kamtar/dykodac2/README.md

# DykoDAC2
Project: https://workspace.circuitmaker.com/Projects/Details/TomPoliensk/DykoDAC2
<br>
<br>
premake5 project
<br>schematics: https://github.com/kamtar/dykodac2/blob/master/hw-circuit-maker/Released/DykoDAC2.PDF
