kamtar/dykodac2/hw-circuit-maker/Released/DykoDAC2.PDF

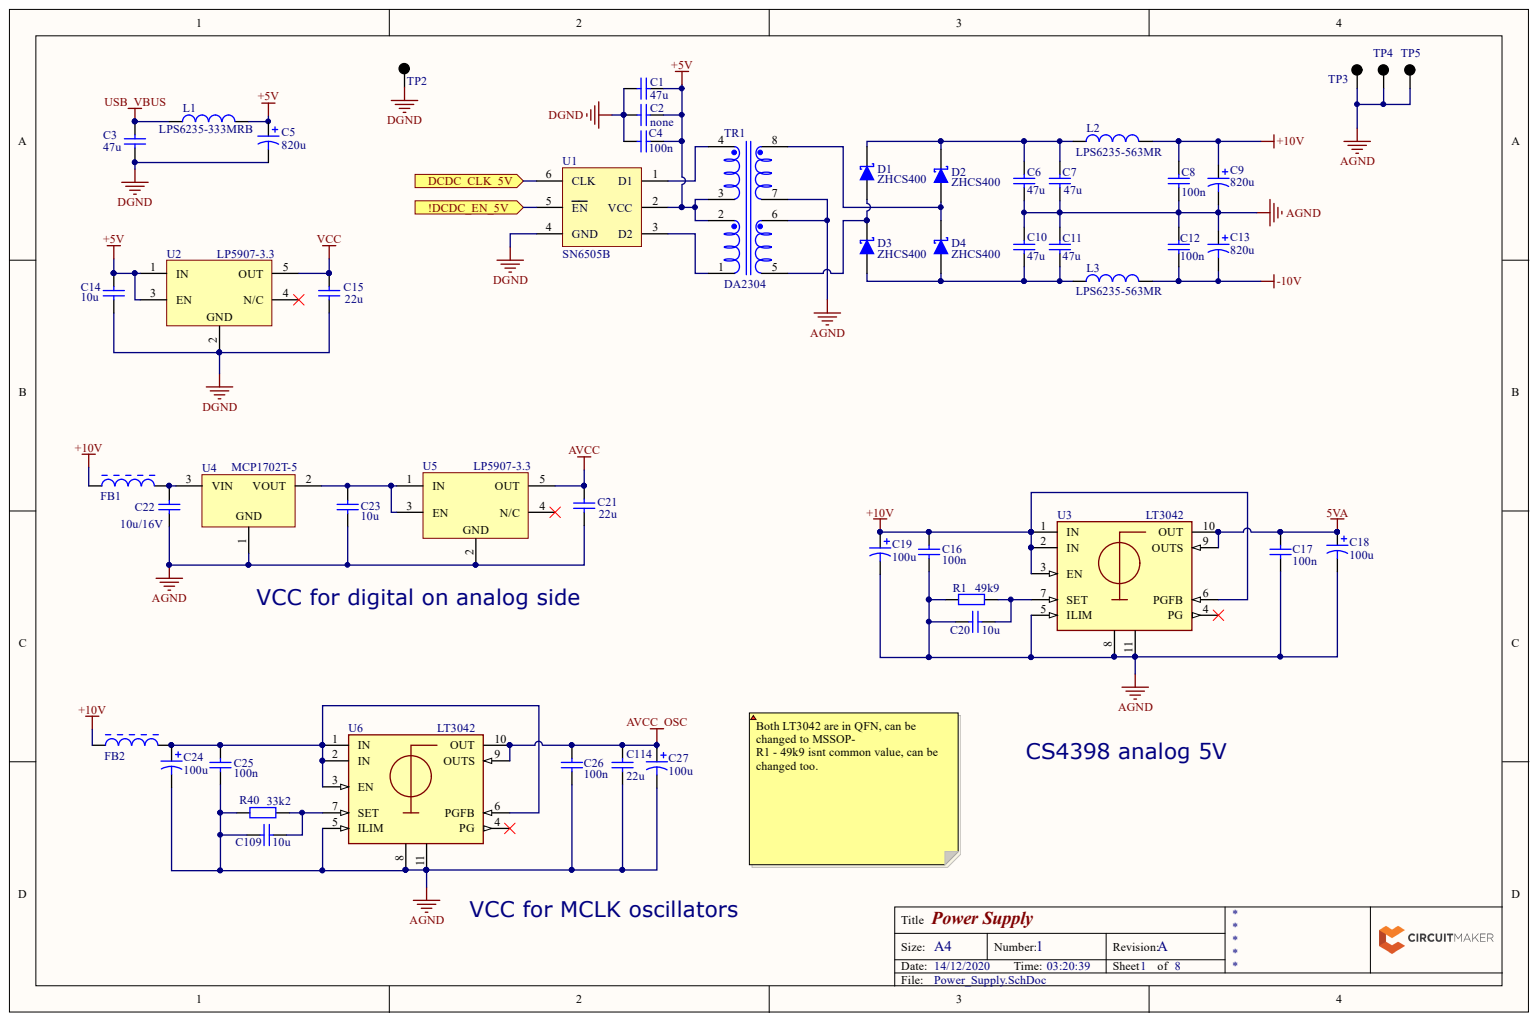
[picture p1: page 1]

VCC for digital on analog side

Both LT3042 are in QFN, can be
changed to MSSOP-
R1 - 49k9 isnt common value, can be
changed too.

PGFB PG | 4 ILIM 5 6 SET 7

VCC for MCLK oscillators

Power Supply Title | * *

Size: A4 | Number: 1 | Revision: A
Date: 14/12/2020 Time: 03:20:39 | | Sheet of

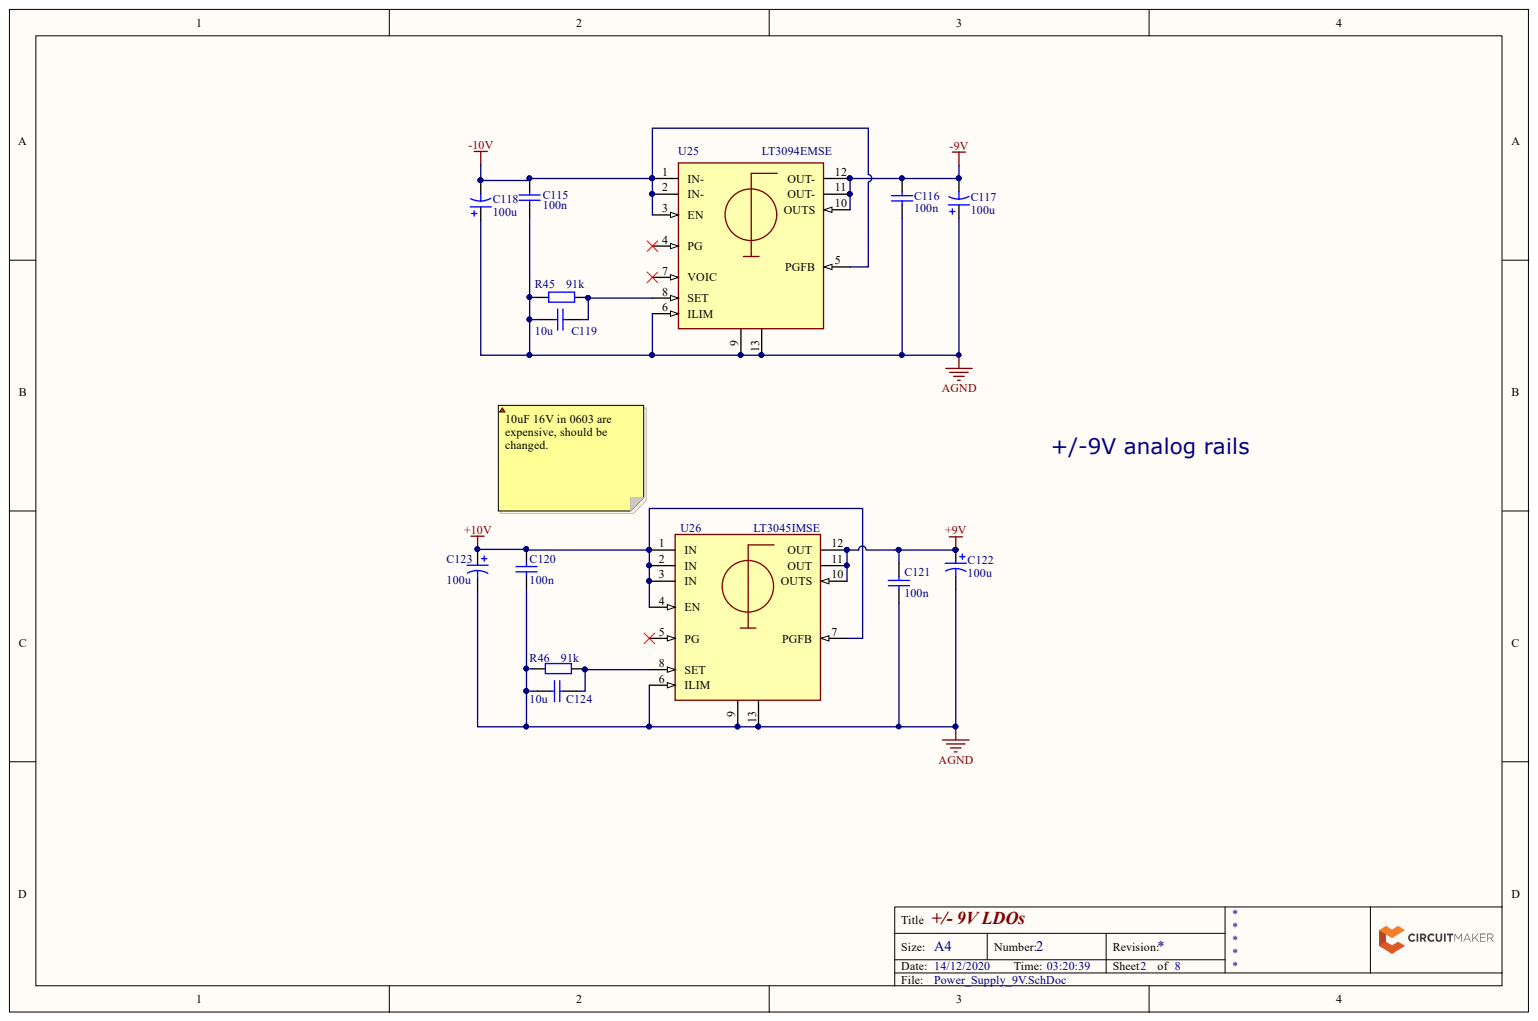
[picture p2: page 2]

C115 100n | IN- 2 | OUTS

EN 3 | 10 OUT-11

+/- 9V LDOs Title | * *

Size: A4 | Number: 2 | Revision: *

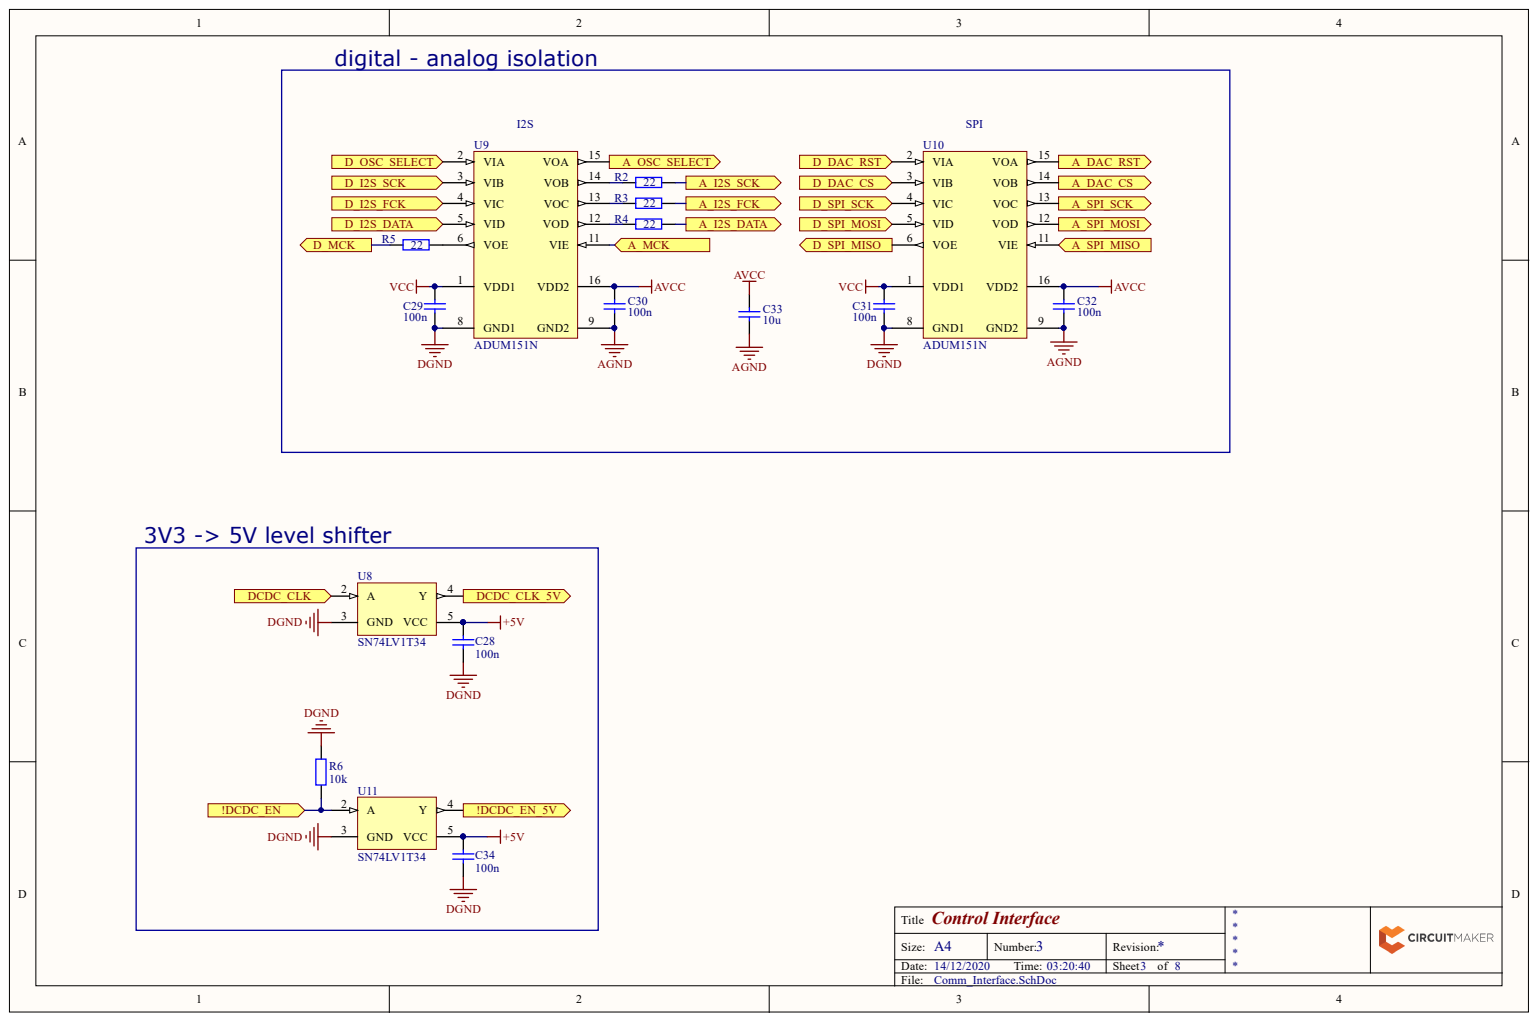
[picture p3: page 3]

Control Interface Title | * *

Size: A4 | Number: 3 | Revision: *

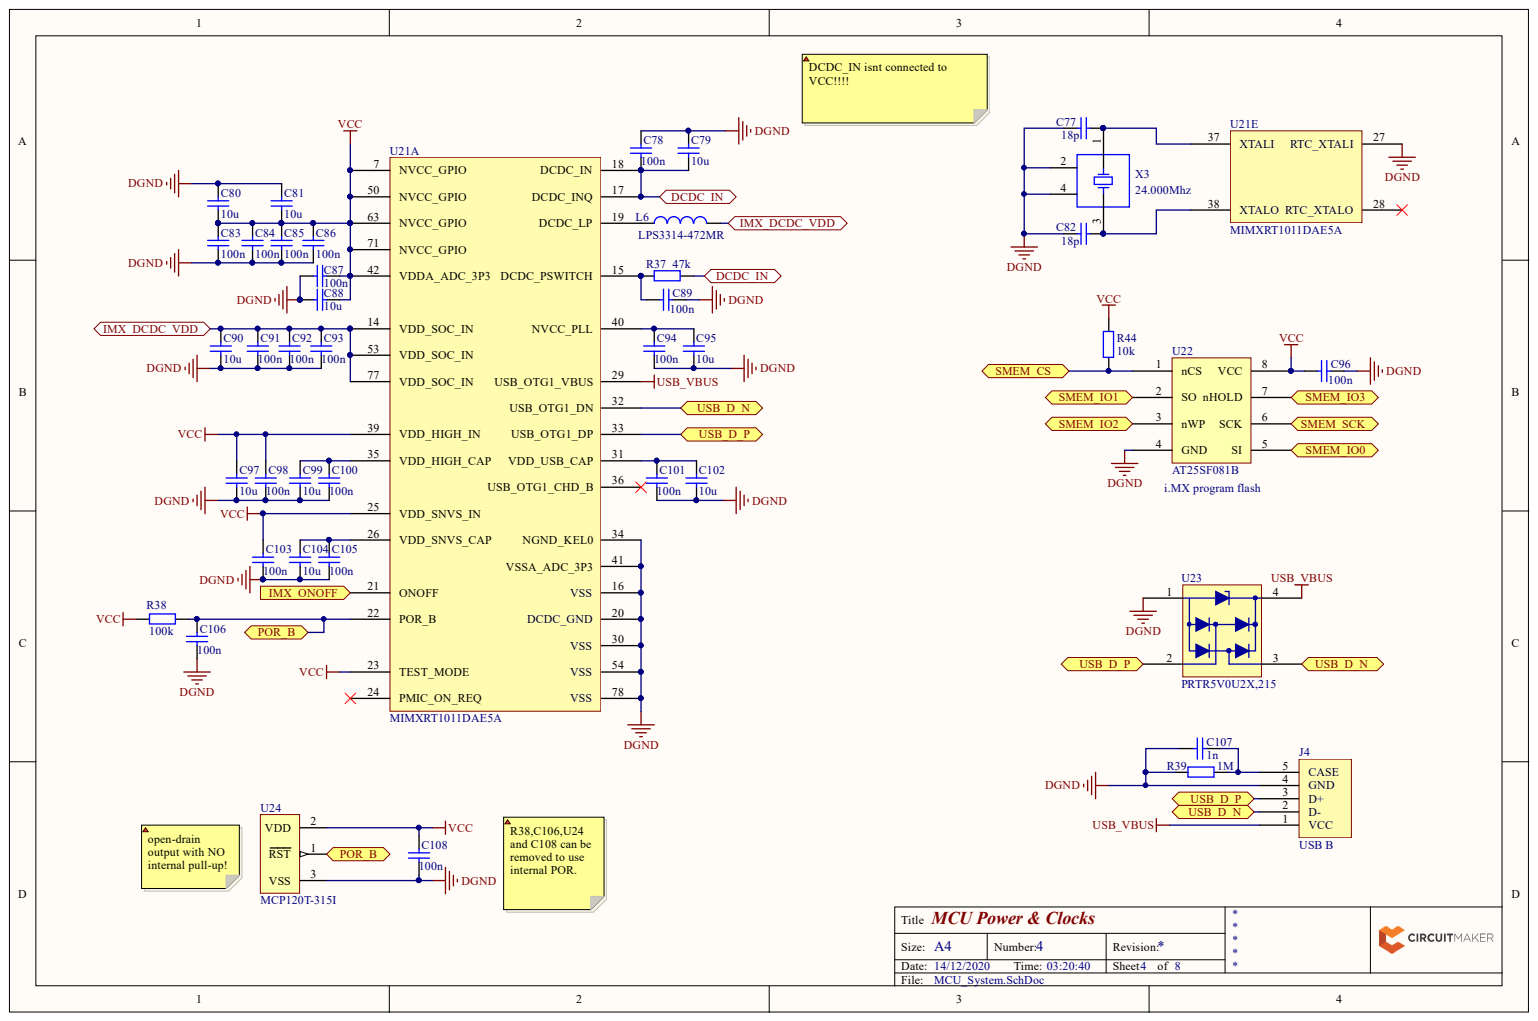
[picture p4: page 4]

XTALO 38

NVCC_GPIO 63 | L6

NVCC_GPIO 71

100n C88 | | | VDD_SOC_IN 14

ONOFF 21

TEST_MODE 23 | DGND

MCU Power & Clocks Title | * *

Size: A4 | Number: 4 | Revision: *

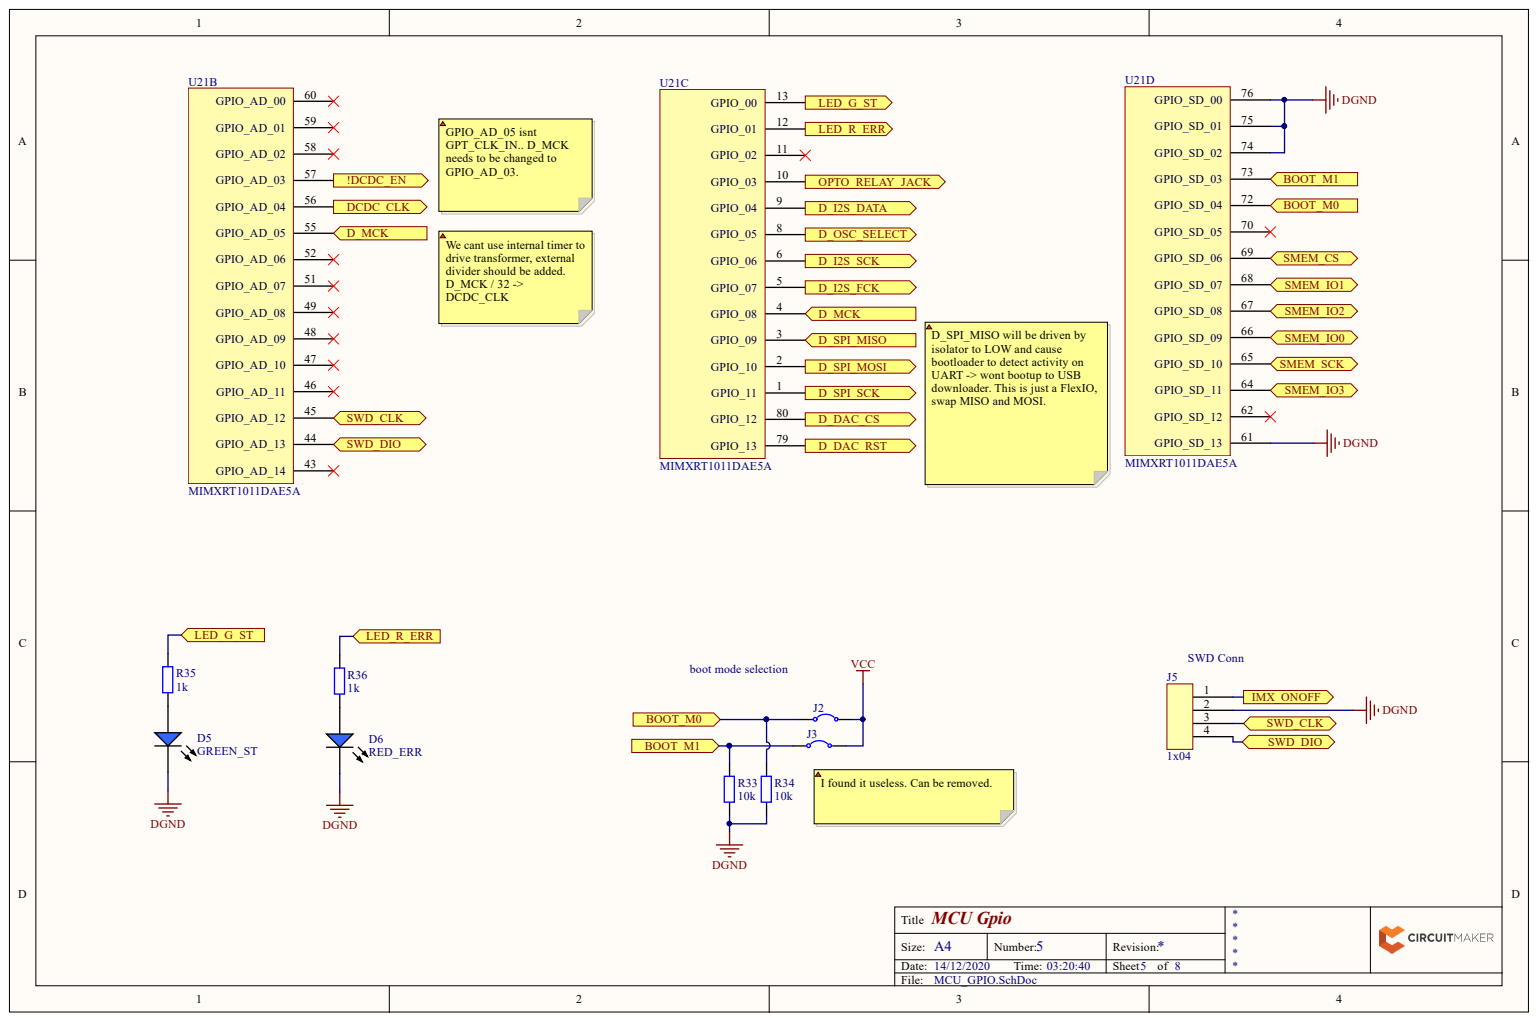
[picture p5: page 5]

We cant use internal timer to
drive transformer, external
divider should be added.
D_MCK / 32 ->
DCDC_CLK

D_SPI_MISO will be driven by
isolator to LOW and cause
bootloader to detect activity on
UART -> wont bootup to USB
downloader. This is just a FlexIO,
swap MISO and MOSI.

I found it useless. Can be removed.

MCU Gpio Title | * *

Size: A4 | Number: 5 | Revision: *

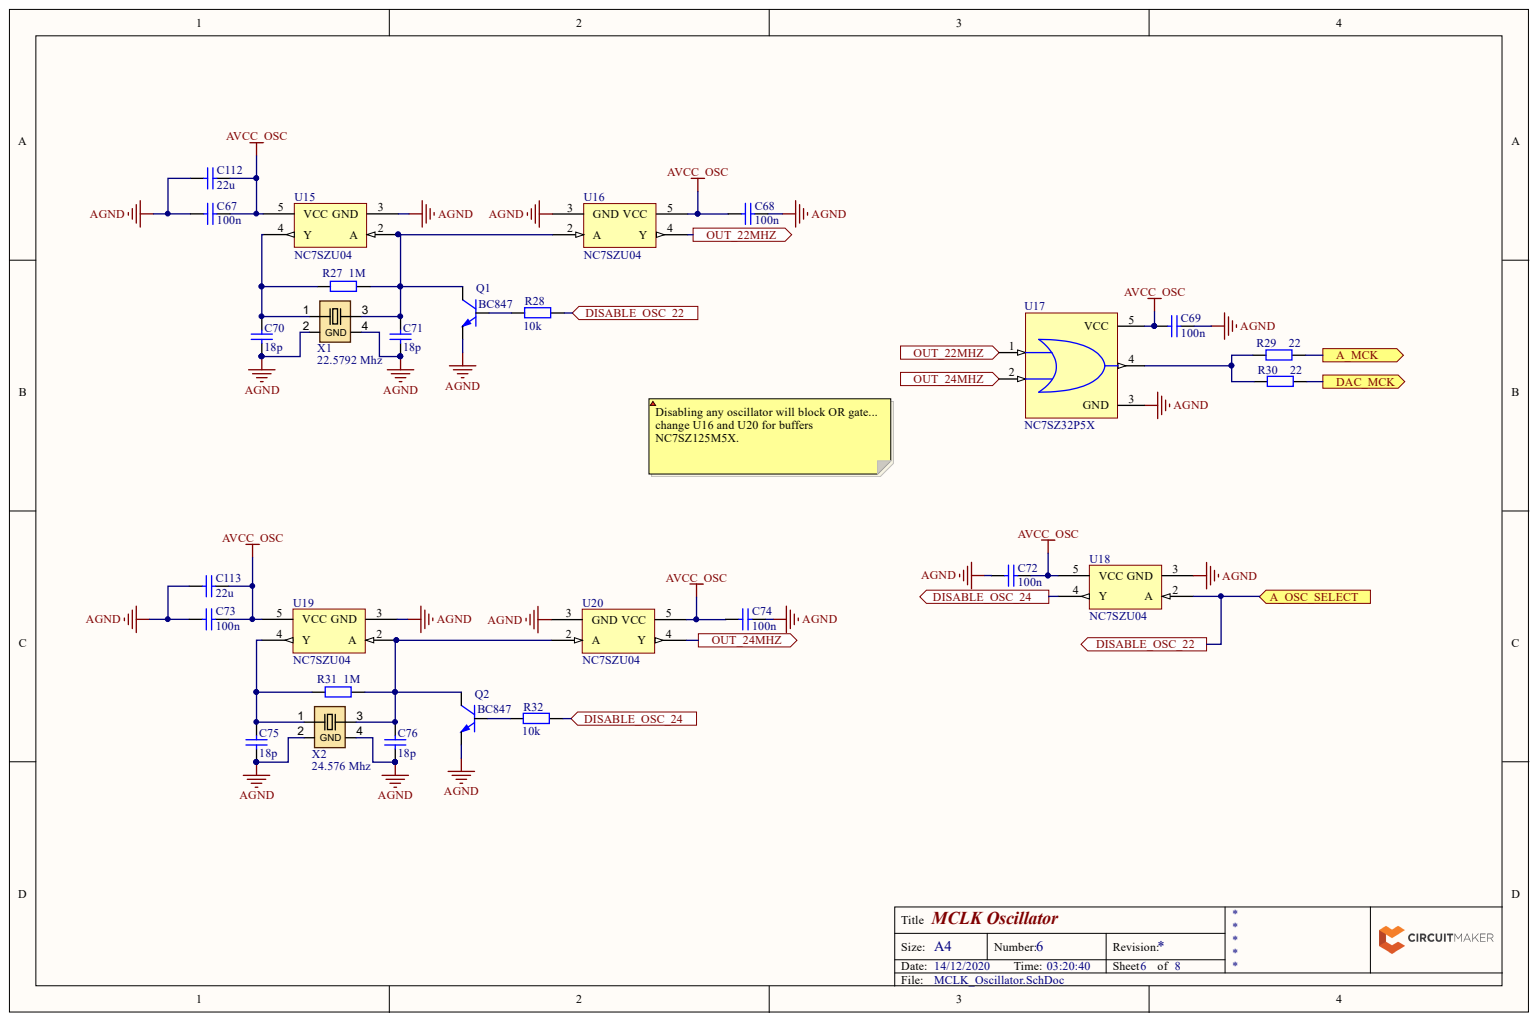
[picture p6: page 6]

Disabling any oscillator will block OR gate...
change U16 and U20 for buffers

MCLK Oscillator Title | * *

Size: A4 | Number: 6 | Revision: *

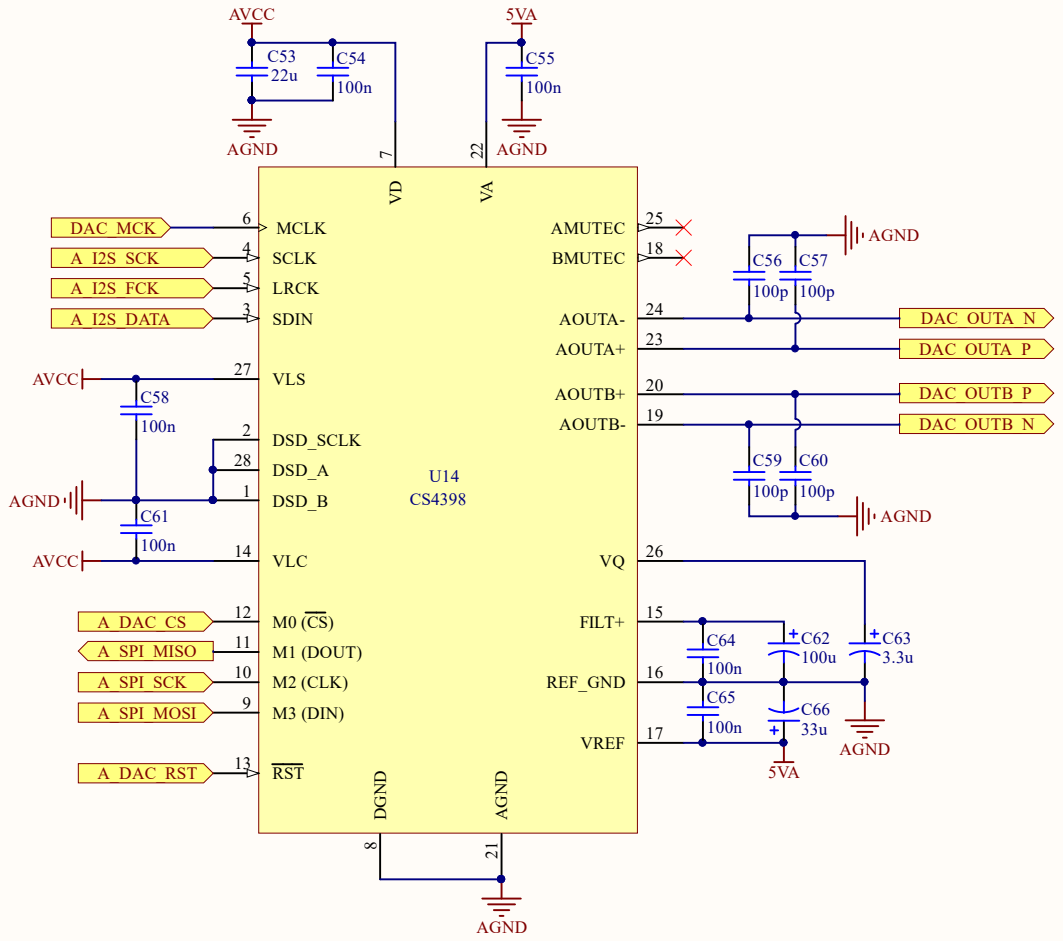
[picture p7: page 7]

CS4398 DAC Title | * *

Size: A4 | Number: 7 | Revision: *

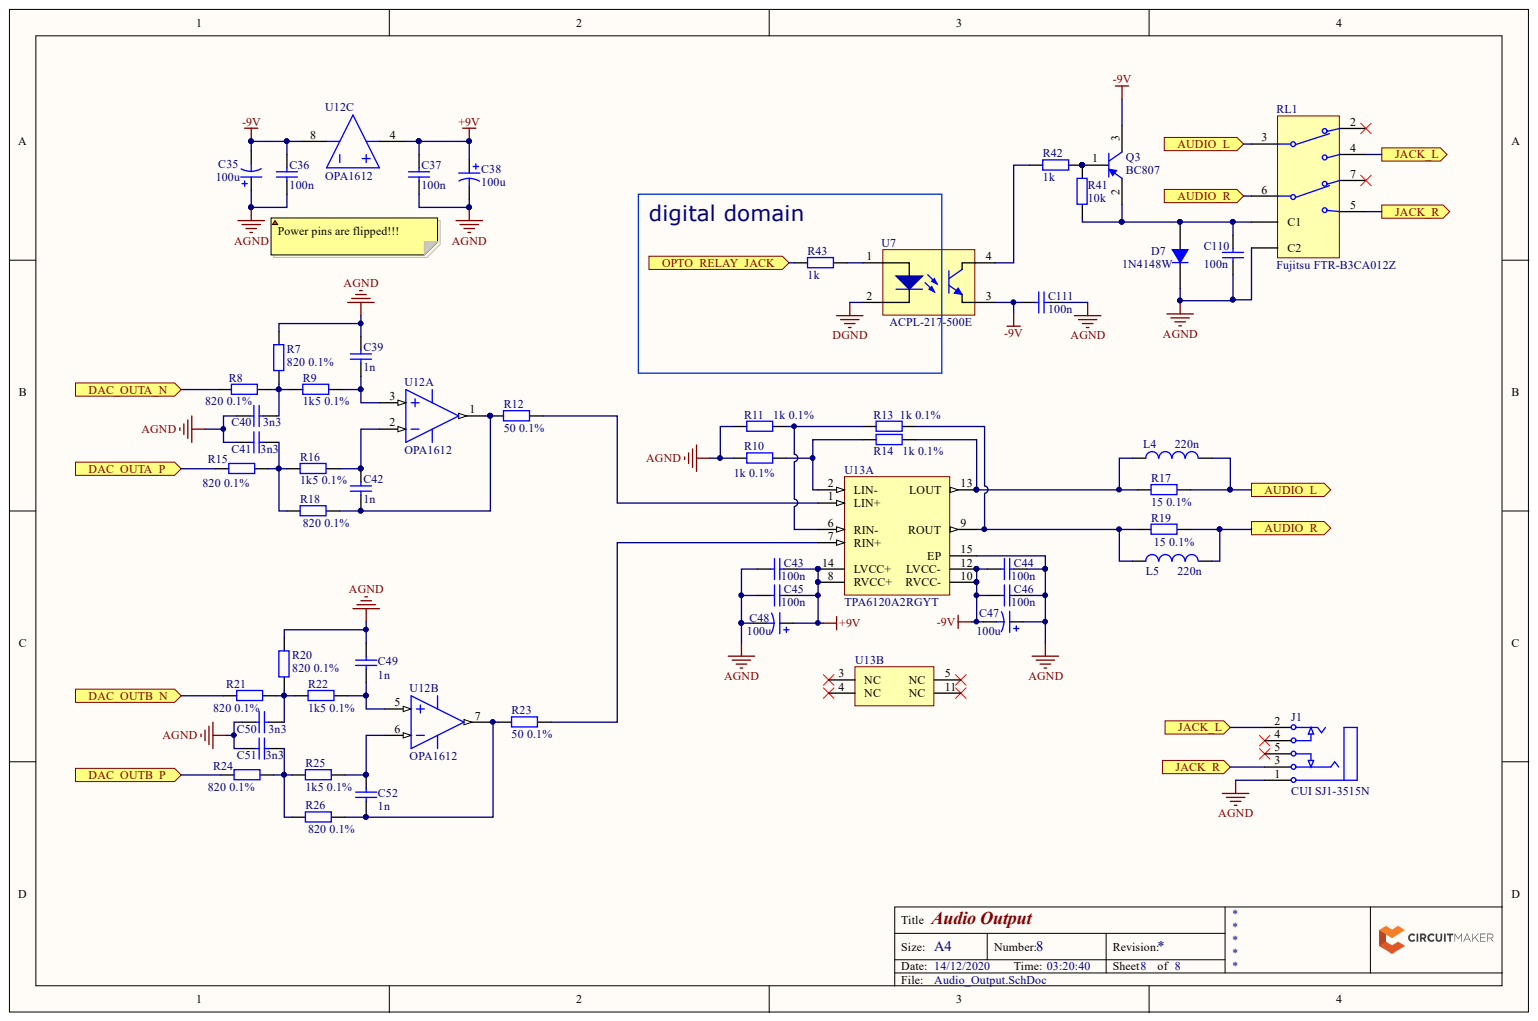
[picture p8: page 8]

digital domain Power pins are flipped!!!

RIN- 6

LVCC+ 14

Audio Output Title | * *

Size: A4 | Number: 8 | Revision: *
