kamtar/dykodac2/(list of files, drawings)

Other design files:
hw-circuit-maker/Design/Audio_Output.SchDoc
hw-circuit-maker/Design/Comm_Interface.SchDoc
hw-circuit-maker/Design/CS4398_DAC.SchDoc
hw-circuit-maker/Design/DykoDAC2.PrjPcb
hw-circuit-maker/Design/MCLK_Oscillator.SchDoc
hw-circuit-maker/Design/MCU_GPIO.SchDoc
hw-circuit-maker/Design/MCU_System.SchDoc
hw-circuit-maker/Design/Power_Supply.SchDoc
hw-circuit-maker/Design/Power_Supply_9V.SchDoc
