kamtar/dykodac2/fw/platform/nxp/main.cpp

#include "app/app_controller.hpp"
#include "audio/audio_engine.hpp"
#include "audio/feedback_controller.hpp"
#include "audio/sample_rate.hpp"
#include "audio/stream_buffer.hpp"
#include "board/clock_manager.hpp"
#include "board/monotonic_timer.hpp"
#include "board/output_relay.hpp"
#include "board/target_board.hpp"
#include "config/board_config.hpp"
#include "devices/dac.hpp"
#include "platform/nxp/flexio_dac_transport.hpp"
#include "platform/nxp/mpu_config.hpp"
#include "platform/nxp/rom_bootloader.hpp"
#include "platform/nxp/boot_control.hpp"
#include "usb/usb_device.hpp"

#include <new>

extern "C" {
#include "clock_config.h"
}

namespace {
enum class StartStep : std::uint8_t { None, RelayRelease, ClockSettle, DmaProgress, Prefill, Stable, DacSettle, Playing };
enum class StopReason : std::uint8_t {
    None, HostStop, Detached, Suspended, HostMuted, UnsupportedRate, UsbInit,
    DacConfigure, EngineStart, DmaNoProgress, Underrun, DmaError, DacUnmute,
    FinalInvariant, VolumeControl
};

struct Runtime {
    board::OutputRelay relay;
    board::ClockManager clocks;
    platform::nxp::FlexioDacTransport transport;
    devices::Cs4398 dac{transport};
    audio::StreamBuffer stream;
    audio::FeedbackController feedback;
    audio::AudioEngine engine;
    usb::UsbDevice usb;
    app::AppController app;
    const audio::FormatConfig* active{nullptr};
    const audio::FormatConfig* desired{nullptr};
    StartStep step{StartStep::None};
    std::uint32_t deadline{0U};
    std::uint32_t dma_baseline{0U};
    std::uint32_t underrun_baseline{0U};
    bool usb_ready{false};
    bool mounted{false};
    bool suspended{false};
    bool stream_requested{false};
    bool resume_pending{false};
    bool bootloader_armed{false};
    std::uint32_t bootloader_deadline{0U};
    bool updater_armed{false};
    std::uint32_t updater_deadline{0U};
    StartStep last_stop_step{StartStep::None};
    StopReason stop_reason{StopReason::None};
};

bool reached(std::uint32_t now, std::uint32_t deadline) {
    return static_cast<std::int32_t>(now - deadline) >= 0;
}

void safe_stop(Runtime& r, bool fault, StopReason reason = StopReason::None) {
    // Preserve the first fault stage/reason. Windows commonly sends one or
    // more alt-0 Stop requests after a failed start; those are consequences,
    // not the root cause and must not overwrite the evidence.
    if (reason != StopReason::None && (fault || r.app.state() != app::State::FaultMuted)) {
        r.last_stop_step = r.step;
        r.stop_reason = reason;
    }
    r.relay.disconnect();
    if (r.dac.ready_muted()) r.dac.set_mute(true);
    r.engine.stop();
    r.stream.clear();
    if (r.active) r.feedback.reset(*r.active, audio::StreamBuffer::capacity_bytes / 2U);
    r.usb.reset_stream();
    r.clocks.invalidate();
    r.step = StartStep::None;
    r.resume_pending = false;
    r.usb.set_clock_valid(false);
    r.app.dispatch(fault ? app::Event::Fault : app::Event::StopRequested);
    if (!fault) r.app.dispatch(app::Event::Stopped);
}

void enter_connected_idle(Runtime& r) {
    // A normal host alt-0 transition is only a pause while USB remains
    // mounted. Keep the already-settled analog path connected and feed the
    // DAC digital zero so relay switching cannot expose channel DC offset.
    r.engine.detach_stream();
    r.stream.clear();
    r.usb.reset_stream();
    r.usb.set_clock_valid(true);
    r.underrun_baseline = r.engine.underruns();
    r.resume_pending = false;
    r.stop_reason = StopReason::HostStop;
}

void begin_start(Runtime& r, std::uint32_t now) {
    r.relay.disconnect();
    r.dac.set_mute(true);
    r.engine.stop();
    r.stream.clear();
    r.usb.set_clock_valid(false);
    r.clocks.invalidate();
    r.resume_pending = false;
    if (r.app.state() == app::State::FaultMuted) {
        r.app.dispatch(app::Event::ClearFault);
        r.app.dispatch(app::Event::StreamRequested);
    } else if (r.app.state() == app::State::Playing) r.app.dispatch(app::Event::RateRequested);
    else if (r.app.state() == app::State::IdleMuted) r.app.dispatch(app::Event::StreamRequested);
    r.step = StartStep::RelayRelease;
    r.deadline = now + config::board::relay_release_us / 1'000U;
}

void run_start(Runtime& r, std::uint32_t now) {
    if (r.step == StartStep::None || !r.desired) return;
    switch (r.step) {
    case StartStep::RelayRelease:
        if (!reached(now, r.deadline)) break;
        r.clocks.select(r.desired->family);
        r.deadline = now + config::board::oscillator_settle_us / 1'000U;
        r.step = StartStep::ClockSettle;
        break;
    case StartStep::ClockSettle:
        if (!reached(now, r.deadline)) break;
        r.clocks.mark_stable();
        if (!r.dac.configure_format(*r.desired)) { safe_stop(r, true, StopReason::DacConfigure); break; }
        if (!r.engine.start_silence(*r.desired)) { safe_stop(r, true, StopReason::EngineStart); break; }
        r.active = r.desired;
        if (r.app.state() == app::State::SwitchingRate) r.app.dispatch(app::Event::StreamRequested);
        r.usb.set_active_format(*r.active);
        r.dma_baseline = r.engine.dma_completions();
        r.deadline = now + 20U;
        r.step = StartStep::DmaProgress;
        break;
    case StartStep::DmaProgress:
        if (r.engine.dma_completions() != r.dma_baseline) {
            r.usb.set_clock_valid(true);
            r.step = StartStep::Prefill;
        } else if (reached(now, r.deadline)) {
            r.engine.capture_dma_diagnostics(now);
            safe_stop(r, true, StopReason::DmaNoProgress);
        }
        break;
    case StartStep::Prefill:
        if (r.desired != r.active) { begin_start(r, now); break; }
        if (r.stream.size() >= audio::StreamBuffer::capacity_bytes / 2U) {
            r.engine.attach_stream(r.stream);
            r.underrun_baseline = r.engine.underruns();
            r.deadline = now + config::board::stable_audio_us / 1'000U;
            r.step = StartStep::Stable;
        }
        break;
    case StartStep::Stable:
        if (r.engine.underruns() != r.underrun_baseline) { safe_stop(r, true, StopReason::Underrun); break; }
        if (reached(now, r.deadline)) {
            if (r.usb.controls().muted) { safe_stop(r, false, StopReason::HostMuted); break; }
            if (!r.dac.set_mute(false)) { safe_stop(r, true, StopReason::DacUnmute); break; }
            r.deadline = now + config::board::dac_settle_us / 1'000U;
            r.step = StartStep::DacSettle;
        }
        break;
    case StartStep::DacSettle:
        if (!reached(now, r.deadline)) break;
        if (!r.clocks.stable() || !r.engine.running() || r.dac.muted() ||
            r.stream.size() < audio::StreamBuffer::capacity_bytes / 4U) { safe_stop(r, true, StopReason::FinalInvariant); break; }
        r.app.dispatch(app::Event::AudioStable);
        r.relay.connect();
        r.step = StartStep::Playing;
        break;
    case StartStep::Playing: break;
    default: break;
    }
}

void update_leds(Runtime& r, std::uint32_t now) {
    const bool fault = r.app.state() == app::State::FaultMuted;
    const bool playing = r.app.state() == app::State::Playing;
    if (fault) {
        const bool on = ((now / 125U) & 1U) != 0U;
        board::target::set_red_led(on);
        board::target::set_green_led(on);
        return;
    }

    // As-built front-panel meaning: green is the 44.1-kHz family and red is
    // the 48-kHz family. Only the LED for the physically selected oscillator
    // is used, except that a fault flashes both LEDs.
    const bool family_48k = r.clocks.selected() == audio::ClockFamily::Family48k;
    bool on = true;
    if (!r.mounted) {
        // With no PC connected, give a short heartbeat once every five seconds.
        on = (now % 5'000U) < 100U;
    } else if (playing && !r.stream_requested) {
        // The PC is connected and the analog path remains settled, but no
        // stream is active. Blink more slowly than the cold/muted idle state.
        on = ((now / 1'500U) & 1U) != 0U;
    } else if (!playing) {
        // Enumerated but idle: slowly blink the selected oscillator.
        on = ((now / 500U) & 1U) != 0U;
    }
    board::target::set_red_led(on && family_48k);
    board::target::set_green_led(on && !family_48k);
}

std::uint16_t narrow_counter(std::uint32_t value) {
    return static_cast<std::uint16_t>(value > 0xFFFFU ? 0xFFFFU : value);
}

void refresh_diagnostics(Runtime& r, std::uint32_t now) {
    usb::maintenance::DiagnosticReport report{};
    report.uptime_ms = now;
    report.last_set_cur_rate_hz = r.usb.last_set_cur_rate();
    report.desired_rate_hz = r.desired ? r.desired->format.sample_rate_hz : 0U;
    report.active_rate_hz = r.active ? r.active->format.sample_rate_hz : 0U;
    report.feedback_16_16 = r.feedback.value();
    report.usb_packet_count = r.usb.packet_count();
    report.dropped_packets = r.usb.dropped_packets();
    report.dropped_events = r.usb.dropped_events();
    report.dma_completions = r.engine.dma_completions();
    report.dma_errors = narrow_counter(r.engine.dma_errors());
    report.underruns = narrow_counter(r.engine.underruns());
    report.overflows = narrow_counter(r.stream.overflows());
    report.padding_errors = narrow_counter(r.usb.padding_errors());
    report.ring_fill_bytes = narrow_counter(static_cast<std::uint32_t>(r.stream.size()));
    report.last_packet_bytes = r.usb.last_packet_size();
    report.minimum_packet_bytes = r.usb.minimum_packet_size();
    report.maximum_packet_bytes = r.usb.maximum_packet_size();
    report.start_step = static_cast<std::uint8_t>(r.step);
    report.last_stop_step = static_cast<std::uint8_t>(r.last_stop_step);
    report.stop_reason = static_cast<std::uint8_t>(r.stop_reason);
    report.event_queue_depth = r.usb.event_queue_depth();
    report.last_interface_alt = r.usb.last_interface_alt();
    report.state = static_cast<std::uint8_t>(r.app.state()) & 0x0FU;
    if (r.clocks.selected() == audio::ClockFamily::Family48k) report.state |= 0x10U;
    if (r.usb.last_interface_alt() == 1U) report.state |= 0x20U;
    if (r.stream_requested) report.state |= 0x40U;
    if (r.usb.controls().muted) report.state |= 0x80U;
    if (r.mounted) report.flags |= 0x01U;
    if (r.suspended) report.flags |= 0x02U;
    if (r.clocks.stable()) report.flags |= 0x04U;
    if (board::target::clock_select_level()) report.flags |= 0x08U;
    if (r.dac.muted()) report.flags |= 0x10U;
    if (r.relay.connected()) report.flags |= 0x20U;
    if (r.engine.running()) report.flags |= 0x40U;
    if (r.usb.clock_valid()) report.flags |= 0x80U;
    r.usb.update_diagnostics(report);
}
} // namespace

int main() {
    platform::nxp::configure_mpu();
    board::target::initialize_diagnostic_led_early();
    board::target::set_red_led(true);
    BOARD_InitBootClocks();
    board::target::initialize_early_safe();
    board::target::initialize_digital();
    board::target::initialize_dac_bus();
    // The working prototype enables the external analog DC/DC through its
    // package-pin-60 bodge (GPIO_AD_00/GPIO1_IO14), not the schematic pin.
    board::target::set_dcdc_enabled(true);

    // Runtime contains the 8 KiB audio ring. Static storage keeps it out of
    // the configured 8 KiB main/interrupt stack; construction still occurs
    // here, after the hardware-verified clock and safe-GPIO startup order.
    alignas(Runtime) static std::uint8_t runtime_storage[sizeof(Runtime)];
    Runtime& runtime = *::new (static_cast<void*>(runtime_storage)) Runtime;
    runtime.relay.initialize_safe();
    runtime.clocks.initialize_safe();
    if (!board::MonotonicTimer::initialize(SystemCoreClock)) for (;;) __asm volatile("wfi");
    const bool trial_boot = platform::nxp::boot_control::trial_boot();
    runtime.app.dispatch(app::Event::Initialize);
    runtime.dac.begin(board::MonotonicTimer::now_ms());

    for (;;) {
        const std::uint32_t now = board::MonotonicTimer::now_ms();
        runtime.dac.poll(now);
        if (!runtime.usb_ready && runtime.dac.ready_muted()) {
            runtime.desired = &audio::supported_format(0U);
            runtime.active = runtime.desired;
            runtime.feedback.reset(*runtime.active, audio::StreamBuffer::capacity_bytes / 2U);
            if (!runtime.usb.initialize(runtime.stream, runtime.feedback)) { safe_stop(runtime, true, StopReason::UsbInit); }
            else { runtime.usb_ready = true; runtime.usb.set_active_format(*runtime.active); runtime.app.dispatch(app::Event::Initialized); }
        }
        if (runtime.usb_ready) runtime.usb.task();
        for (usb::EventRecord usb_event = runtime.usb.take_event(); usb_event.event != usb::Event::None;
             usb_event = runtime.usb.take_event()) switch (usb_event.event) {
        case usb::Event::Mounted: runtime.mounted = true; runtime.suspended = false; break;
        case usb::Event::Start:
            runtime.stream_requested = true;
            // Re-resolve the stream format from the clock rate most recently
            // selected by the host. This also handles hosts that send SET_CUR
            // before changing the streaming alternate setting.
            runtime.desired = audio::find_format(runtime.usb.requested_rate());
            if (!runtime.desired) { safe_stop(runtime, true, StopReason::UnsupportedRate); break; }
            runtime.usb.start_feedback();
            if (runtime.app.state() == app::State::Playing && runtime.engine.running() &&
                runtime.relay.connected() && !runtime.dac.muted() && runtime.clocks.stable() &&
                runtime.active == runtime.desired) {
                // Resume the existing settled path. Continue sending zeroes
                // until USB has refilled half the ring, then join the stream.
                runtime.usb.set_clock_valid(true);
                runtime.resume_pending = true;
            } else {
                begin_start(runtime, now);
            }
            break;
        case usb::Event::Rate:
            runtime.desired = audio::find_format(usb_event.value);
            if (!runtime.desired) safe_stop(runtime, true, StopReason::UnsupportedRate);
            else {
                runtime.feedback.reset(*runtime.desired, audio::StreamBuffer::capacity_bytes / 2U);
                // Some hosts repeat SET_CUR while resuming the same format.
                // Do not turn that harmless repeat into a relay cycle.
                if (runtime.stream_requested && runtime.desired != runtime.active)
                    begin_start(runtime, now);
            }
            break;
        case usb::Event::Controls:
            if (usb_event.control == usb::Control::Volume) {
                const auto volume = static_cast<std::int16_t>(static_cast<std::int32_t>(usb_event.value));
                if (!runtime.dac.set_attenuation(volume)) safe_stop(runtime, true, StopReason::VolumeControl);
            } else if (usb_event.control == usb::Control::Mute) {
                if (usb_event.value != 0U) { runtime.relay.disconnect(); runtime.dac.set_mute(true); }
                else if (runtime.stream_requested) begin_start(runtime, now);
            }
            break;
        case usb::Event::Stop:
            runtime.stream_requested = false;
            if (runtime.mounted && runtime.app.state() == app::State::Playing &&
                runtime.engine.running() && runtime.relay.connected() && !runtime.dac.muted())
                enter_connected_idle(runtime);
            else
                safe_stop(runtime, false, StopReason::HostStop);
            break;
        case usb::Event::Detached: runtime.mounted = false; runtime.suspended = false; runtime.stream_requested = false; safe_stop(runtime, false, StopReason::Detached); break;
        case usb::Event::Suspended: runtime.suspended = true; runtime.stream_requested = false; safe_stop(runtime, false, StopReason::Suspended); break;
        case usb::Event::Resumed: runtime.suspended = false; break;
        case usb::Event::Diagnostics:
            refresh_diagnostics(runtime, now);
            runtime.usb.send_diagnostics();
            break;
        case usb::Event::EventTrace:
            runtime.usb.send_event_trace();
            break;
        case usb::Event::DmaDiagnostics: {
            if (runtime.engine.running()) runtime.engine.capture_dma_diagnostics(now);
            const auto& source = runtime.engine.dma_diagnostics();
            usb::maintenance::DmaDiagnosticReport report{};
            report.captured_ms = source.captured_ms;
            report.dmamux_chcfg = source.dmamux_chcfg;
            report.dma_es = source.dma_es;
            report.tcd_saddr = source.tcd_saddr;
            report.tcd_daddr = source.tcd_daddr;
            report.tcd_nbytes = source.tcd_nbytes;
            report.sai_tcsr = source.sai_tcsr;
            report.sai_tcr1 = source.sai_tcr1;
            report.sai_tcr2 = source.sai_tcr2;
            report.sai_tcr3 = source.sai_tcr3;
            report.sai_tfr0 = source.sai_tfr0;
            report.dma_erq = source.dma_erq;
            report.dma_int = source.dma_int;
            report.dma_hrs = source.dma_hrs;
            report.tcd_citer = source.tcd_citer;
            report.tcd_biter = source.tcd_biter;
            report.tcd_csr = source.tcd_csr;
            runtime.usb.update_dma_diagnostics(report);
            runtime.usb.send_dma_diagnostics();
            break;
        }
        case usb::Event::BootloaderArm:
            if (runtime.bootloader_armed && !reached(now, runtime.bootloader_deadline)) {
                safe_stop(runtime, false);
                runtime.relay.disconnect();
                board::target::set_dac_reset(true);
                platform::nxp::enter_rom_serial_downloader();
            }
            runtime.bootloader_armed = true;
            runtime.bootloader_deadline = now + 2'000U;
            break;
        case usb::Event::UpdaterArm:
            if (runtime.updater_armed && !reached(now, runtime.updater_deadline)) {
                safe_stop(runtime, false);
                runtime.relay.disconnect();
                board::target::set_dac_reset(true);
                platform::nxp::boot_control::request_updater();
            }
            runtime.updater_armed = true;
            runtime.updater_deadline = now + 2'000U;
            break;
        default: break;
        }
        if (runtime.resume_pending && runtime.stream_requested &&
            runtime.stream.size() >= audio::StreamBuffer::capacity_bytes / 2U) {
            runtime.engine.attach_stream(runtime.stream);
            runtime.underrun_baseline = runtime.engine.underruns();
            runtime.resume_pending = false;
        }
        run_start(runtime, now);
        if (runtime.bootloader_armed && reached(now, runtime.bootloader_deadline)) runtime.bootloader_armed = false;
        if (runtime.updater_armed && reached(now, runtime.updater_deadline)) runtime.updater_armed = false;
        if (runtime.app.state() != app::State::FaultMuted && runtime.engine.dma_errors() != 0U)
            safe_stop(runtime, true, StopReason::DmaError);
        else if (runtime.app.state() != app::State::FaultMuted &&
                 runtime.engine.underruns() > runtime.underrun_baseline + 2U)
            safe_stop(runtime, true, StopReason::Underrun);
        update_leds(runtime, now);
        refresh_diagnostics(runtime, now);
        if (trial_boot) {
            platform::nxp::boot_control::watchdog_refresh();
            platform::nxp::boot_control::poll_trial_health(now,
                runtime.usb_ready && runtime.dac.ready_muted() && runtime.app.state() != app::State::FaultMuted);
        }
        __asm volatile("wfi");
    }
}
