kamtar/dykodac2/fw/platform/nxp/sha256.cpp

#include "platform/nxp/sha256.hpp"
#include <cstring>

namespace platform::nxp::crypto {
namespace {
constexpr std::uint32_t k[64] = {
    0x428a2f98U,0x71374491U,0xb5c0fbcfU,0xe9b5dba5U,0x3956c25bU,0x59f111f1U,0x923f82a4U,0xab1c5ed5U,
    0xd807aa98U,0x12835b01U,0x243185beU,0x550c7dc3U,0x72be5d74U,0x80deb1feU,0x9bdc06a7U,0xc19bf174U,
    0xe49b69c1U,0xefbe4786U,0x0fc19dc6U,0x240ca1ccU,0x2de92c6fU,0x4a7484aaU,0x5cb0a9dcU,0x76f988daU,
    0x983e5152U,0xa831c66dU,0xb00327c8U,0xbf597fc7U,0xc6e00bf3U,0xd5a79147U,0x06ca6351U,0x14292967U,
    0x27b70a85U,0x2e1b2138U,0x4d2c6dfcU,0x53380d13U,0x650a7354U,0x766a0abbU,0x81c2c92eU,0x92722c85U,
    0xa2bfe8a1U,0xa81a664bU,0xc24b8b70U,0xc76c51a3U,0xd192e819U,0xd6990624U,0xf40e3585U,0x106aa070U,
    0x19a4c116U,0x1e376c08U,0x2748774cU,0x34b0bcb5U,0x391c0cb3U,0x4ed8aa4aU,0x5b9cca4fU,0x682e6ff3U,
    0x748f82eeU,0x78a5636fU,0x84c87814U,0x8cc70208U,0x90befffaU,0xa4506cebU,0xbef9a3f7U,0xc67178f2U};
constexpr std::uint32_t rotr(std::uint32_t x, unsigned n) { return (x >> n) | (x << (32U - n)); }
std::uint32_t load_be(const std::uint8_t* p) {
    return (static_cast<std::uint32_t>(p[0]) << 24U) | (static_cast<std::uint32_t>(p[1]) << 16U) |
           (static_cast<std::uint32_t>(p[2]) << 8U) | p[3];
}
}

Sha256::Sha256() noexcept : state_{0x6a09e667U,0xbb67ae85U,0x3c6ef372U,0xa54ff53aU,
                                  0x510e527fU,0x9b05688cU,0x1f83d9abU,0x5be0cd19U} {}

void Sha256::transform(const std::uint8_t block[64]) noexcept {
    std::uint32_t w[64];
    for (unsigned i=0;i<16U;++i) w[i]=load_be(block+4U*i);
    for (unsigned i=16U;i<64U;++i) {
        const auto s0=rotr(w[i-15U],7)^rotr(w[i-15U],18)^(w[i-15U]>>3U);
        const auto s1=rotr(w[i-2U],17)^rotr(w[i-2U],19)^(w[i-2U]>>10U);
        w[i]=w[i-16U]+s0+w[i-7U]+s1;
    }
    auto a=state_[0],b=state_[1],c=state_[2],d=state_[3],e=state_[4],f=state_[5],g=state_[6],h=state_[7];
    for (unsigned i=0;i<64U;++i) {
        const auto s1=rotr(e,6)^rotr(e,11)^rotr(e,25);
        const auto ch=(e&f)^((~e)&g);
        const auto t1=h+s1+ch+k[i]+w[i];
        const auto s0=rotr(a,2)^rotr(a,13)^rotr(a,22);
        const auto maj=(a&b)^(a&c)^(b&c);
        const auto t2=s0+maj;
        h=g;g=f;f=e;e=d+t1;d=c;c=b;b=a;a=t1+t2;
    }
    state_[0]+=a;state_[1]+=b;state_[2]+=c;state_[3]+=d;
    state_[4]+=e;state_[5]+=f;state_[6]+=g;state_[7]+=h;
}

void Sha256::update(const void* source, std::size_t size) noexcept {
    const auto* p=static_cast<const std::uint8_t*>(source); bytes_+=size;
    while(size!=0U) {
        const std::size_t take=(64U-used_)<size?(64U-used_):size;
        std::memcpy(block_+used_,p,take); used_+=take;p+=take;size-=take;
        if(used_==64U){transform(block_);used_=0U;}
    }
}

void Sha256::finish(std::uint8_t digest[32]) noexcept {
    const std::uint64_t bits=bytes_*8U;
    block_[used_++]=0x80U;
    if(used_>56U){while(used_<64U)block_[used_++]=0U;transform(block_);used_=0U;}
    while(used_<56U)block_[used_++]=0U;
    for(unsigned i=0;i<8U;++i)block_[63U-i]=static_cast<std::uint8_t>(bits>>(8U*i));
    transform(block_);
    for(unsigned i=0;i<8U;++i){digest[4U*i]=static_cast<std::uint8_t>(state_[i]>>24U);digest[4U*i+1U]=static_cast<std::uint8_t>(state_[i]>>16U);digest[4U*i+2U]=static_cast<std::uint8_t>(state_[i]>>8U);digest[4U*i+3U]=static_cast<std::uint8_t>(state_[i]);}
}
} // namespace platform::nxp::crypto
