kamtar/dykodac2/fw/audio/audio_engine.hpp

#pragma once

#include "audio/audio_format.hpp"
#include "audio/stream_buffer.hpp"

namespace audio {
struct DmaDiagnosticSnapshot {
    std::uint32_t captured_ms{0U};
    std::uint32_t dmamux_chcfg{0U};
    std::uint32_t dma_es{0U};
    std::uint32_t tcd_saddr{0U};
    std::uint32_t tcd_daddr{0U};
    std::uint32_t tcd_nbytes{0U};
    std::uint32_t sai_tcsr{0U};
    std::uint32_t sai_tcr1{0U};
    std::uint32_t sai_tcr2{0U};
    std::uint32_t sai_tcr3{0U};
    std::uint32_t sai_tfr0{0U};
    std::uint16_t dma_erq{0U};
    std::uint16_t dma_int{0U};
    std::uint16_t dma_hrs{0U};
    std::uint16_t tcd_citer{0U};
    std::uint16_t tcd_biter{0U};
    std::uint16_t tcd_csr{0U};
};

class AudioEngine {
public:
    bool start_silence(const FormatConfig& config) noexcept;
    bool start(const FormatConfig& config, StreamBuffer& stream) noexcept;
    void stop() noexcept;
    void attach_stream(StreamBuffer& stream) noexcept { stream_ = &stream; }
    void detach_stream() noexcept { stream_ = nullptr; }
    bool running() const noexcept { return running_; }
    std::uint32_t dma_completions() const noexcept { return dma_completions_; }
    std::uint32_t dma_errors() const noexcept { return dma_errors_; }
    std::uint32_t underruns() const noexcept { return underruns_; }
    void capture_dma_diagnostics(std::uint32_t now_ms) noexcept;
    const DmaDiagnosticSnapshot& dma_diagnostics() const noexcept { return dma_diagnostics_; }
    void on_dma_complete(bool success) noexcept;
private:
    bool submit_silence() noexcept;
    volatile std::uint32_t dma_completions_{0U};
    volatile std::uint32_t dma_errors_{0U};
    volatile std::uint32_t underruns_{0U};
    volatile bool running_{false};
    StreamBuffer* stream_{nullptr};
    std::size_t transfer_bytes_{0U};
    DmaDiagnosticSnapshot dma_diagnostics_{};
};
} // namespace audio
