kamtar/dykodac2/fw/platform/nxp/update_layout.cpp

#include "platform/nxp/update_layout.hpp"

namespace platform::nxp::update {
std::uint32_t crc32(const void* data, std::size_t size) noexcept {
    const auto* bytes = static_cast<const std::uint8_t*>(data);
    std::uint32_t crc = 0xFFFFFFFFU;
    for (std::size_t i = 0; i < size; ++i) {
        crc ^= bytes[i];
        for (unsigned bit = 0; bit < 8U; ++bit)
            crc = (crc >> 1U) ^ (0xEDB88320U & (0U - (crc & 1U)));
    }
    return ~crc;
}
} // namespace platform::nxp::update
