kamtar/dykodac2/(commit log)

2020-12-14 circuit maker files
    [Audio_Output.SchDoc, BOM_PartType-DykoDAC2.csv, CS4398_DAC.SchDoc, Comm_Interface.SchDoc, DykoDAC2.PrjPcb, MCLK_Oscillator.SchDoc, MCU_GPIO.SchDoc, MCU_System.SchDoc]
2026-07-22 Update vendored NXP RT1010 device layer
2026-07-22 first stable prototype
2026-07-22 switched LEDs around
2026-07-22 ledswap and bootloader
